bharath4793/Sensebox/Trash/Report.docx

ΕΞΩΦΥΛΟ

Acknowledgements

## Abstract

Nomenclature

- MC / MCU Microcontroller
- RH Relative Humidity
- °C Degrees Celsius
- EMC Electromagnetic Compatibility

# 1. Introduction

The purpose of this project is to measure the weather and virtualize the data. The data gathering process is implemented upon Arduino, an open source hardware prototyping platform, which allows an easy implementation of sensors and interactive elements. Data gathered by Arduino are stored on a database and on the next level these data are used to make graphs on different platforms. Also the project included a live weather camera that rotates to spot almost everywhere the user wants.

## 1.1. Motivation

Building my own weather station was an idea that came into my mind about two years ago. I first thought of building it for educational purposes and as a hobby. Later on I realized that the project could also serve as my final year’s project so I declared it.

My interested on weather data has been inherited from my favorite sport – Sailing. For sailors observing the weather is a major part of their daily routine so this was the icing on the cake to begin!

## 1.2. Purposes and targets

Sdasdasd

## 1.3. Project Structure

The project is split in four parts.

a) The Arduino part in which data are gathered.
b) The server part that hosts the server-side PHP code that is used to store and retrieve data from the database.
c) The Android Application part that visualizes the data.
d) The Web Site part that also visualizes the data.

# 2. Implementation Methodology

Cvsdfsdf

# 3. Project Plan

The project has been implemented using the latest technologies available for its needs. The next chapter state of the art provides a more in depth analysis about the background of the project.

## 3.1. State Of The Art

- Open – Source Hardware

Open - Source has become a popular expression, but mostly with regard to software. The principles and definitions of Open-Source Hardware (OSHW) are closely related to those of Open-Source Software (OSS) from the Open Source Initiative [1, 2]. Interested people can study, modify, distribute, make and sell designs based on those of OSHW products [3]. Through open development, people get the possibility to learn and understand how OSHW works, so that they are able to control and modify their technology. Machines, devices, or other physical things produced under the OSHW license must comply with the definitions of the Open Source Hardware Association [1].

- Arduino Platform

Arduino is a prototyping platform containing a microcontroller board (MC) as core element, a programming language and an integrated development environment (IDE) [4]. OSHW MCs from Arduino are based on ATmega8, ATmega168, ATmega2560 and latest boards on ATmega32u4 (http://arduino.cc/en/Main/ArduinoBoardYun), Sitara AM335x (http://arduino.cc/en/Main/ArduinoBoardTre). They can be used to develop interactive prototypes, which are using input from sensors to control output devices connected to the same board. The capabilities of the MCs allow several methods for in- and outputs of signals.

The simplified IDE with a wire-based programming language also allows beginners to realize complex projects in short time. Documentation of the IDE and the language reference can be found on the Arduino homepage [5]. All code samples are released into the public domain. Additionally, the language can be extended with C++ libraries to enable more functionality. All official software tools from Arduino are published under the OSS license and are platform-independent.

The well documented Arduino hard- and software makes it even possible to rebuild MCs by oneself. However, pre-assembled Arduino boards are relatively inexpensive compared to other commercial MC platforms available on the market

- Raspberry PI

The Raspberry PI is a credit – card – sized single board computer developed mainly for educational purposes. As core element it has a Broadcom BCM2835 system on a chip (SoC) [9] which includes an ARM11 family 700MHz processor, a VideoCore IV GPU and 512MB RAM.

The Raspberry PI foundation provides a lightweight version of Debian (Raspbian) and Arch Linux ARM distribution as official operating systems.

Tools are available for Python as the main programming language, C, Java and Perl.

For the needs of the project, the RPI is used as server, hosting the script files that are used to store and retrieve weather data in the database as well as hosting the web page. Later it is explained why the RPI is the perfect small server.

- Automated Weather Stations

Automated weather stations (AWSs) are meteorological stations, which perform climatic observations and data transmission automatically [6]. Main advantages compared to human weather observations are, that measurements, read out by a central data-acquisition unit, are more reliable and can be performed much more frequently. Sensors of an AWS are operated by a microprocessor. It allows exact sampling of sensor data and processing for averaging or filtering of the samples. The result will be a series of observations which are representative over a limited area.

- Android Platform

Android is a mobile operating system based on the Linux Kernel that is currently developed by Google. It powers hundreds of millions of mobile devices around the world. It is the largest installed base of any mobile operating system platform.

Android’s source code is released by Google under open source licenses (Apache License 2.0 and GNU General Public License 2.0 [7, 8]).

Its open nature has encouraged a large community of developers and enthusiasts to use the open – source code as a foundation for community-driven projects, which adds new features for advanced users.

- Google Chart API

The Google Chart API [10] is a tool that lets people easily create a chart from some data and embed it in a web page. Google creates a PNG (http://en.wikipedia.org/wiki/Portable_Network_Graphics) image of a chart from data and formatting parameters in an HTTP (http://en.wikipedia.org/wiki/HTTP) request. Many types of charts are supported, and by making the request into an image tag, people can simply include the chart in a web page.

# 4. Basic Part

//TODO REQUIREMENT ANALYSIS

## 4.1. Hardware Components

The Microcontroller controls the data storage process and sampling frequency. Sampling rates of sensors are depending on the time constant value that we set. Sensors and Microcontroller functionality is explained in depth in the upcoming section.

### 4.1.1. Arduino

The Arduino and the Ethernet Shield can be imagined as the ‘brain’ of the weather station. It provides all the core functionality from sensor manipulation up to data logging. The Arduino Mega and the Arduino Ethernet Shield are introduced below.

#### 4.1.1.1. Arduino Mega 2560 R3

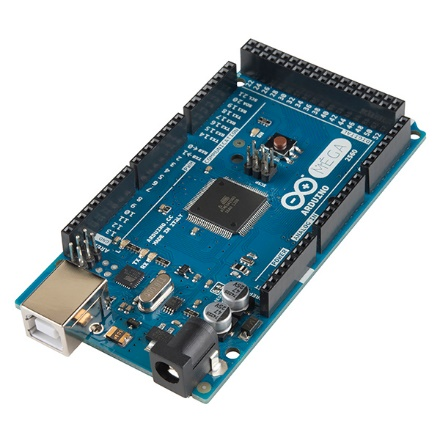
[picture p3: figure]

Figure 1 - The Arduino Mega 2560 R3 Microcontroller Board

Arduino Mega 2560 [11] is the board that is powered by ATmega2560. Its main advantages compared to other Arduino boards are the clock speed of 16MHz, the flash memory of 256Kbytes of the ATmega2560 chip and the 8Kbytes SRAM. The large flash and SRAM memories offer the Arduino vast of space for more interactive components to be added in future improvements.

The Arduino Mega provides 54 digital pins. They can be used as input or output and are operating at 5V. Each pin can provide or receive a maximum of 40mA and has an internal pull-up resistor of 20 – 50 kΩ. The pull-up resistor is disconnected by default but they can be accessed from software by setting the pinMode() as INPUT_PULLUP. This effectively inverts the behavior of the INPUT mode, where HIGH means the sensor is off, and LOW means the sensor is on. In addition, some pins have specialized functions:

- Serial: 0 (RX) and 1 (TX); Serial 1: 19 (RX) and 18 (TX); Serial 2: 17 (RX) and 16 (TX); Serial 3: 15 (RX) and 14 (TX).

Used to receive (RX) and transmit (TX) TTL serial data. Pins 0 and 1 are also connected to the corresponding pins of the ATmega16U2 USB-to-TTL Serial chip.

- External Interrupts: 2 (interrupt 0), 3 (interrupt 1), 18 (interrupt 5), 19 (interrupt 4), 20 (interrupt 3), and 21 (interrupt 2).

These pins can be configured to trigger an interrupt on a low value, a rising or falling edge, or a change in value. See the attachInterrupt() function for details.

- PWM: 2 to 13 and 44 to 46.

Provide 8-bit PWM output with the analogWrite() (http://arduino.cc/en/Reference/AnalogWrite) function.

- SPI: 50 (MISO), 51 (MOSI), 52 (SCK), 53 (SS).

These pins support SPI communication using the SPI library.

- LED: 13.

There is a built-in LED connected to digital pin 13. When the pin is HIGH value, the LED is on, when the pin is LOW, it's off.

- TWI: 20 (SDA) and 21 (SCL).

Support TWI communication using the Wire library (http://arduino.cc/en/Reference/Wire).

(BMP085 sensor uses the Wire protocol to communicate with Arduino)

The Mega2560 has 16 analog inputs, each of which provide 10 bits of resolution (i.e. 2¹⁰ different values). By default they measure from ground to 5 volts, though is it possible to change the upper end of their range using the AREF pin and analogReference() function.

#### 4.1.1.2. Arduino Ethernet Shield

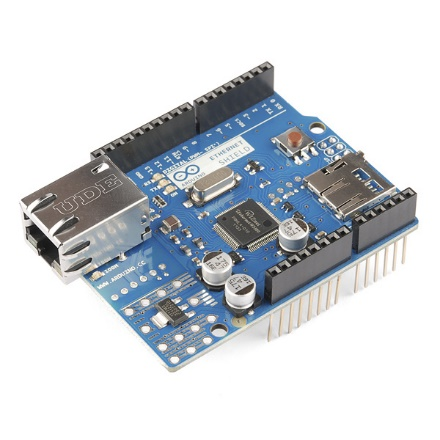
[picture p4: figure]

Figure 2 - The Arduino Ethernet Shield

The Ethernet shield [12] is powered by a Wiznet W5100 ethernet controller and also includes a micro SD card slot for storage purposes. It is made exclusively for Arduino boards and connects over the SPI port.

The Wiznet W5100 provides a network (IP) stack capable of both TCP and UDP. It supports up to four simultaneous socket connections. The ethernet shield connects to an Arduino board using long wire-wrap headers which extend through the shield. This keeps the pin layout intact and allows another shield to be stacked on top.

The Ethernet Shield has a standard RJ-45 connection, with an integrated line transformer and Power over Ethernet enabled.

It worth mentioning that pins SPI pins cannot be used as digital in or output any more when using the Ethernet Shield as they are being used by the SPI bus. Pins 4, 10 are used for the SD card and cannot be used as well. All the other pins are free to be used.

The Ethernet Shield is used in the project for data logging and as server for controlling the pan-tilt camera mount.

To integrate functionalities of the Ethernet Shield into the whole system, Ethernet [13] and SD [14] libraries are used.

### 4.1.2. Sensors

In this section the functionality and the characteristics of each sensors used by the prototype will be analyzed. In addition, connection and communication examples are given in this section.

#### 4.1.2.1. Relative Humidity and Air Temperature (DHT22 or RHT03)

The RHT03 sensor from is made of two parts, a capacitive humidity sensor and a thermistor. There is also a basic chip inside that does some analog to digital conversion and offers a digital signal with the temperature and humidity.

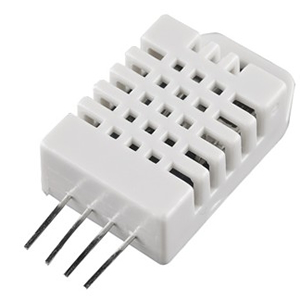
[picture p5: figure]

Figure 3 - RHT03

The RHT03 was chosen because of its high Resolution and Accuracy. Technical Specifications are shown in the table below [15].

Model | DHT 22 also known as RHT03
Power Supply | 3.3 – 6V DC
Output Signal | Digital Signal via MaxDetect 1-wire bus
Sensing Element | Polymer Humidity Capacitor
Operating Range | Humidity: 0 – 100% RH Temperature: - 40 ~ 80 °C
Accuracy | Humidity: +- 2% RH (Max +-5% RH) Temperature: +- 0.5 °C
Resolution or Sensitivity | Humidity: 0.1% RH Temperature: 0.1 °C
Repeatability | Humidity: +- 1% RH Temperature: +- 0.2 °C

Table 1 - RHT03 Technical Specifications

Pin | Function
1 | Power Supply
2 | Data – Signal
3 | NULL
4 | Ground

Table 2 - RHT03 Pin Sequence Number (1, 2, 3, 4 from left to right)

##### Communication and signal

Wire Bus is used for communication between the MCU and RHTY03.

Illustration of MaxDetect’s wire bus:

Data is comprised of integral and decimal part, the following is the formula for data.

- 8bit integral Relative Humidity data
- 8bit decimal Relative Humidity data
- 8bit integral Temperature data
- 8bit decimal Temperature data
- 8but checksum

When MCU send start signal, RHT03 change from standby-status to running-status. When MCU finishs sending the start signal, RHT03 will send response signal of 40-bit data that reflect the relative humidity and temperature to MCU. Without start signal from MCU, RHT03 will not give response signal to MCU. One start signal for one response data from RHT03 that reflect the relative humidity and temperature. RHT03 will change to standby status when data collecting finished if it don't receive start signal from MCU again.

Below one can find the overall communication process. The interval of whole process must beyond two seconds.

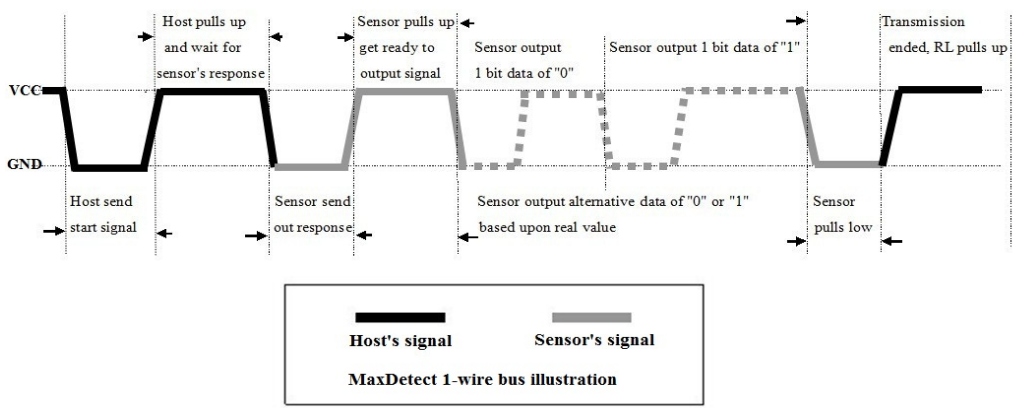
[picture p6: figure]

Figure 4 - RHT03 Communication Process

#### 4.1.2.2. Air Pressure and Temperature (BMP085)

For air pressure readings and temperature the digital sensor BMP085 from Bosch Sensortec is used [16]. It was chosen for the prototype because of its good accuracy through individual precise calibration and its long term stability feature. The main characteristics are summarized in the table below.

Parameter | Condition | Min | Typical | Max | Unit
Resolution | Typical | 0.04 | 0.01 | 0.01 | hPA
Accuracy | Typical | | +- 1.0 | | hPA
Response Time | Mode | 4.5 | | 25.5 | Ms
Operation Range | | 700 | | 1100 | hPA
Supply Voltage | | 1.8 | 2.5 | 3.6 | Volts

Table 3 - Main Properties of the BMP085

It is based on piezo - resistive technology for EMC robustness, high accuracy and linearity as well as long term stability. It is designed to be connected directly to a MCU via the I²C bus. The pressure and temperature data has to be compensated by the calibration data of the E²PROM of the BMP085.

The sensor consists of a piezo – resistive sensor, an analog to digital converter and a control unit with E²PROM and a serial I²C interface. It delivers the uncompensated value of pressure and temperature. The E²PROM has stored 176 bit of individual calibration data. This is used to compensate offset, temperature dependence and other parameters of the sensor.

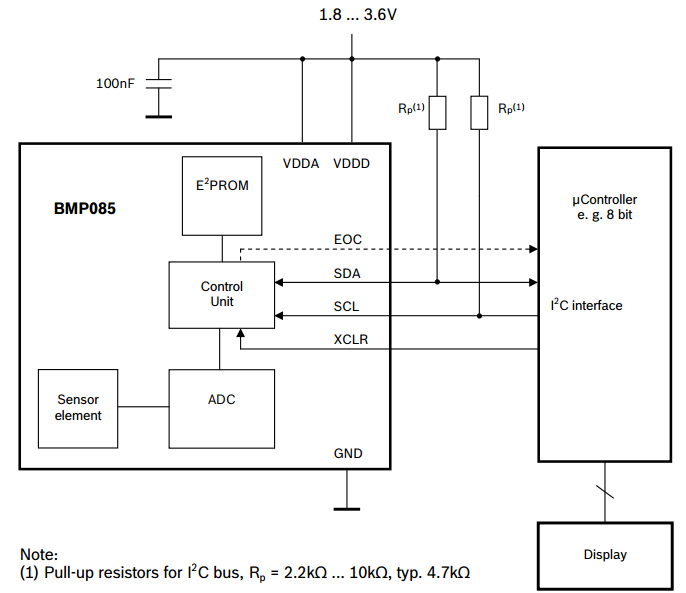
[picture p7: figure]

Figure 5 - BMP085 Application Circuit

The I²C interface and a read-only-memory register (E²PROM) are part of the control unit of the BMP085. In the E²PROM eleven 16bit calibration coefficients are stored and used to compensate offset of temperature and pressure readings. As temperature is a factor for air pressure calculation, it has to be known to calculate the true pressure. Reading of the temperature can be done with the piezo-resistive sensor as well.

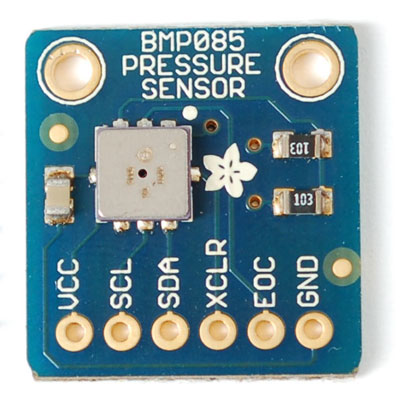
[picture p8: figure]

Figure 6 - BMP085

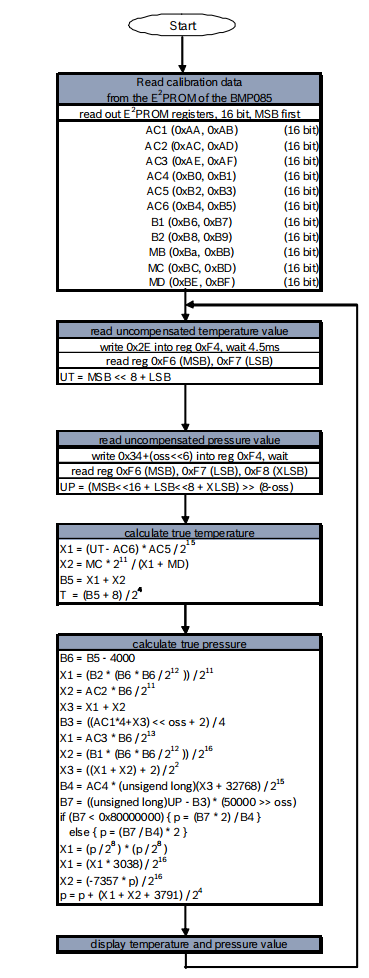
[picture p9: figure]

Figure 7 - Calculation Process of Pressure and Temperature for BMP085

A measurement sequence with the complete algorithm is shown in Figure 6. It has to be implemented to the MCU according to this order.

After the MC has sent a start sequence, the calibration data is requested from the E²PROM registers. The 16 constants need to be read out only once and are stored on the MCU. Then the MCU has to wait for uncompensated temperature (UT) and pressure (UP) readings from the sensors. The stored calibration data is now used to calculate temperature in °C and pressure in Pa. After applying the algorithms, the sensor waits for the next measurement command.

As additional factor for true pressure calculation, an oversampling mode can be chosen to set the internal sampling of the sensor for one measurement. Changing the mode to a higher resolution will increase the accuracy of a measurement but also has an impact on energy consumption, reaction time and the long term stability [17].

Table 4 gives an overview about the four oversampling setting modes. As the weather station is designed for long and continuous measurements, standard mode will be sufficient.

Figure 8 - BMP085 Temperature and Pressure Reading Process

Mode | Oversamping Setting | Internal Samples | Conversion Time (ms) | Noise (hPA)
Ultra Low Power | 0 | 1 | 4.5 | 0.0.6
Standard | 1 | 2 | 7.5 | 0.05
High Resolution | 2 | 4 | 13.5 | 0.0.4
Ultra High Resolution | 3 | 8 | 25.5 | 0.03

Table 4 - Measurement modes of the BMP085 and resolution effects

BMP085 | Arduino Mega Pin
SDA | 20
SCL | 21
XCLR | Not Connected
EOC | Not Connected
GND | GND
VCC | 3.3V

As mentioned before, the BMP085 sensor is using the I²C protocol to communicate with the MCU and has to be connected to SDA and SCL pins of the Arduino Mega as shown below.

Table 5 - BMP085 Pin Connections to Arduino Mega

The altitude of the instrument has to be taken into account as well, because air pressure decreases with increasing height. For getting comparable values it has to be calculated to sea level pressure [6].

Working with the BMP085 should be done carefully, because it could be damaged by shocks or when getting in contact with water. It should be handled as Electrostatic Sensitive Device (ESD) [18] too. Therefore, it should be installed in a dry environment with constant temperature.

#### 4.1.2.3. Precipitation

Rainfall is measured by a Tipping Bucket Rain Gauge included in the Weather Meters Kit [19] available from Sparkfun. Each time the self – emptying tipping bucket is emptied, a reed switch closes once. This corresponds to 0.2794 mm of rain fall [20]. The state change is caught by the MCU using Arduino’s Interrupt input.

A problem that frequently appears at trying to capture the state change of a switch is called bouncing problem. State change means that the input at a digital pin on the Arduino changes from high to low (equals from 5V to 0V) or vice versa. The problem is that each switching contains interferences in the signal before it reaches the level of 5V or 0V. This can lead to multiple counts from only one state switch. A visualization of the problem is shown in Figure 5.

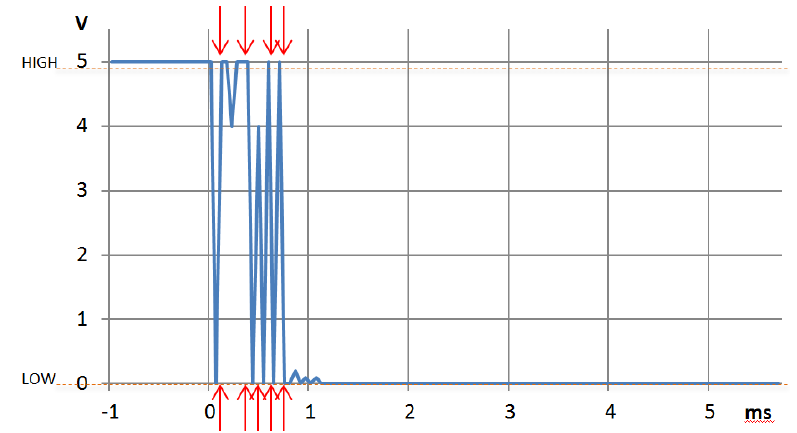
[picture p10: figure]

Figure 9 - Bouncing problem at a digital input. MCU will read nine state changes instead of one

To overcome this problem there are two solutions. The first is to integrate a capacitor to the circuit and the second is to define a software method with a debounce interval of some microseconds (μs), which is called very time a state change is recognized.

For the project the second method is used. The implementation is show below.

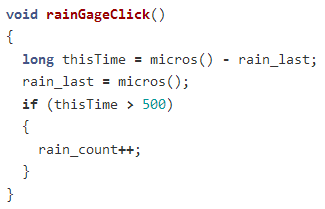
[picture p11: figure]

Figure 10 - Switch Debouncing Implementation

The code above will ignore any interrupt that occurs within 500μs (0.0005s) of the previous one. This technique will limit the max rain this configuration can measure to a very high value that do not corresponds to an earthly value.

##### Wiring the Rain Gauge

The two wires coming from the rain gauge, through the RJ11 cable, have to be connected to the Arduino Mega as shown in the figure below.

Figure 11 - Connection of the Rain Gauge to the Arduino Mega

The red line must be connected to Ground while the green line is pulled up with a 10kΩ resistor to 5V. The output of the sensor has to be connected to digital pin 19 on the Arduino Mega.

A disadvantage of this method is that only rain fall can be measured. To include snow fall in the precipitation measurement a self heated device would be needed. Temperatures below 0° Celsius could also lock up the anemometer. This should be taken into account when analyzing the data of the rain gauge.

# References

[1] Open Source Initiative: The Open Source Definition.

http://opensource.org/docs/osd

[2] Open Source Hardware Association: OSHW Definition.

http://www.oshwa.org/definition/

[3] Definition of Free Cultural Works: Open Source Hardware. http://freedomdefined.org/OSHW (http://freedomdefined.org/OSHW%20)
[4] Arduino: Homepage

http://arduino.cc/en

[5] Arduino: Reference.

http://arduino.cc/en/Reference/HomePage

[6] World Meteorological Organization, 1992: International Meteorological Vocabulary. Second edition, WMO-No. 182,Geneva.
[7] Apache License, Version 2.0

http://www.apache.org/licenses/LICENSE-2.0.html

[8] GNU General Public License, Version 2.0

http://www.gnu.org/licenses/gpl-2.0.html

[9] System on a chip

http://en.wikipedia.org/wiki/System_on_a_chip

[10] Google Charts API

https://developers.google.com/chart/

[11] Arduino Mega 2560 R3 Web page.

http://arduino.cc/en/Main/ArduinoBoardMega2560

[12] Arduino Ethernet Shield Web page.

http://arduino.cc/en/Main/ArduinoEthernetShield

[13] Arduino Ethernet Library Web page.

http://arduino.cc/en/reference/ethernet

[14] Arduino SD Library Web page.

http://arduino.cc/en/Reference/SD

[15] RHT03 Official Datasheet.

http://dlnmh9ip6v2uc.cloudfront.net/datasheets/Sensors/Weather/RHT03.pdf

[16] Bosch Sensortec: Pressure Sensors.

http://goo.gl/SEpmgY

[17] BMP085 Datasheet.

http://dlnmh9ip6v2uc.cloudfront.net/datasheets/Sensors/Pressure/BST-BMP085-DS000-06.pdf

[18] Electrostatic Sensitive Device

http://en.wikipedia.org/wiki/Electrostatic-sensitive_device

[19] Sparkfun Electronics: Weather Meters Kit

https://www.sparkfun.com/products/8942

[20] Sparkfun Electronics: Weahter Meters Datasheet

https://www.sparkfun.com/datasheets/Sensors/Weather/Weather%20Sensor%20Assembly..pdf
