bharath4793/Sensebox/Raw Data/Pics/20141013_182844.jpg

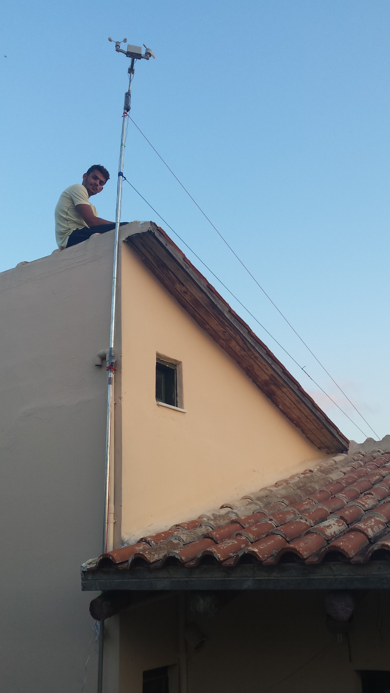
Raw Data/Pics/20141013_182844.jpg
