bharath4793/Sensebox/Raw Data/Pics/android_app/2014-10-21 00.14.27.png

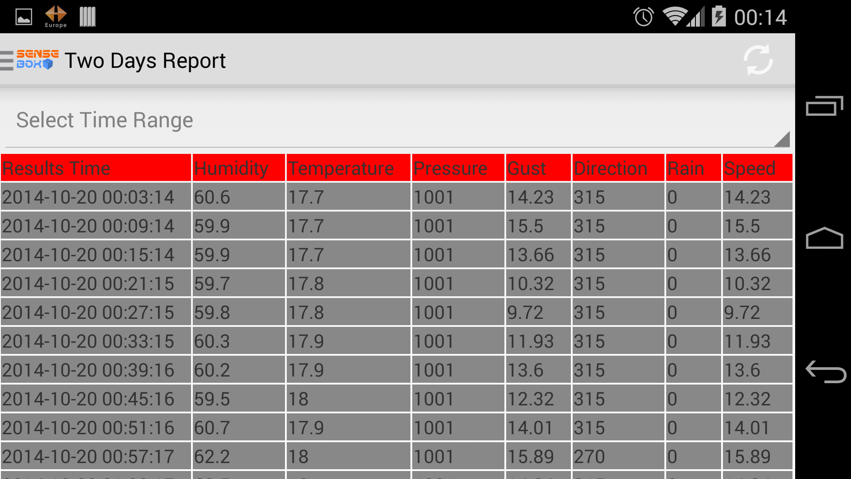
Raw Data/Pics/android_app/2014-10-21 00.14.27.png
