bharath4793/Sensebox/Raw Data/Pics/android_app/2014-10-21 00.14.45.png

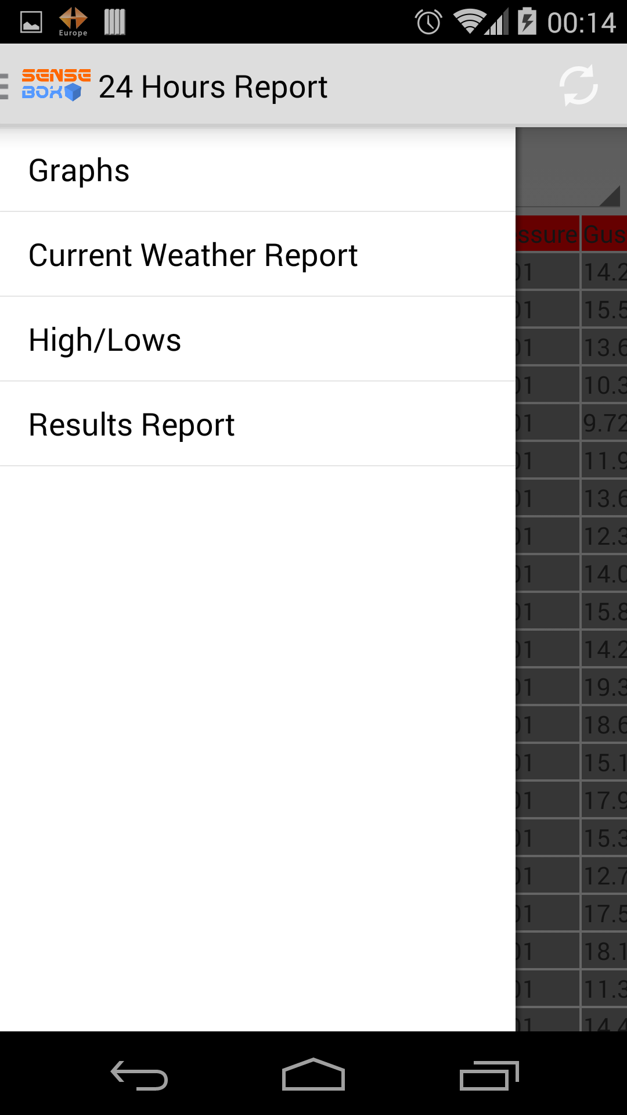
Raw Data/Pics/android_app/2014-10-21 00.14.45.png
