bharath4793/Sensebox/Raw Data/Pics/Arduino-Mega-2560-with-ethernet-shield-1024.JPG

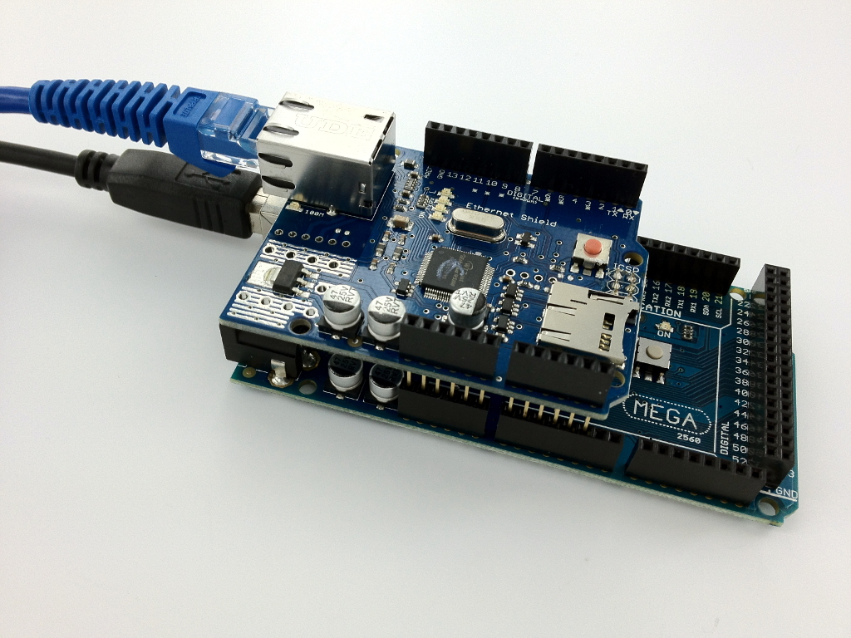
Raw Data/Pics/Arduino-Mega-2560-with-ethernet-shield-1024.JPG
