bharath4793/Sensebox/Raw Data/Pics/BMP085/bmp085_circuit.png

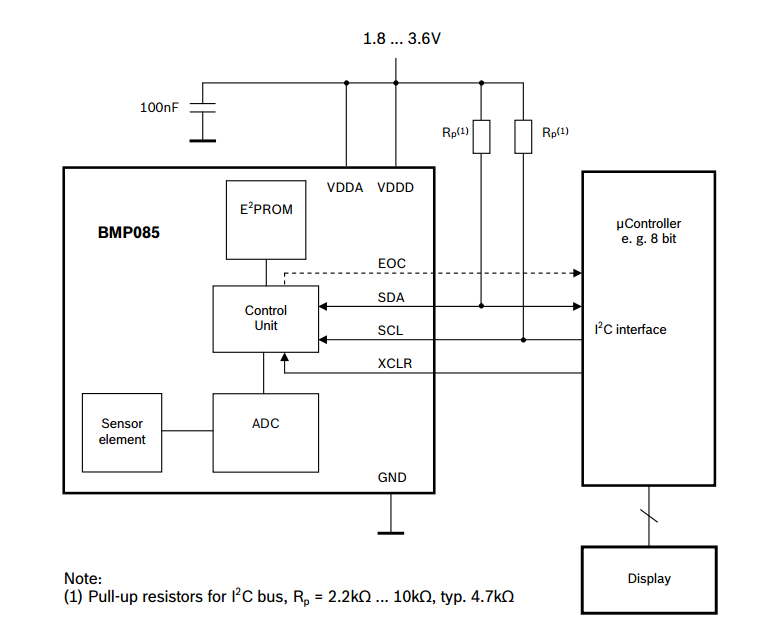
Raw Data/Pics/BMP085/bmp085_circuit.png
