bharath4793/Sensebox/Raw Data/Pics/crontab.png

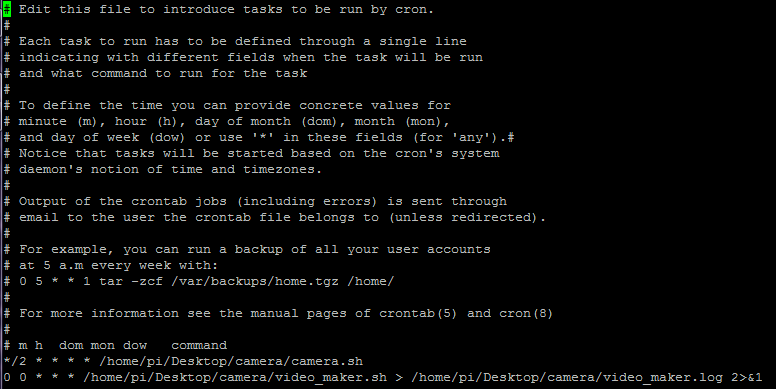
Raw Data/Pics/crontab.png
