bharath4793/Sensebox/Raw Data/Pics/draw_charts_code/drawGraphs.png

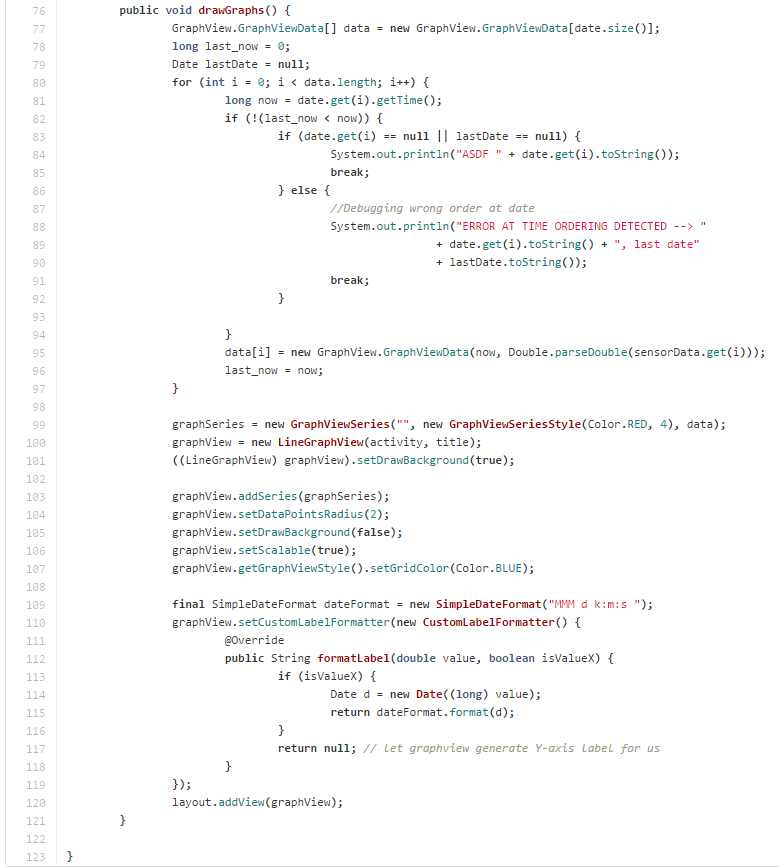
Raw Data/Pics/draw_charts_code/drawGraphs.png
