bharath4793/Sensebox/Raw Data/Pics/draw_charts_code/json_structor.png

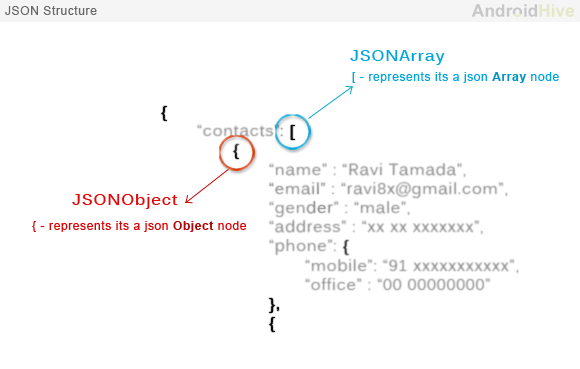
Raw Data/Pics/draw_charts_code/json_structor.png
