bharath4793/Sensebox/Raw Data/Pics/draw_charts_code/jsonArray_filling.png

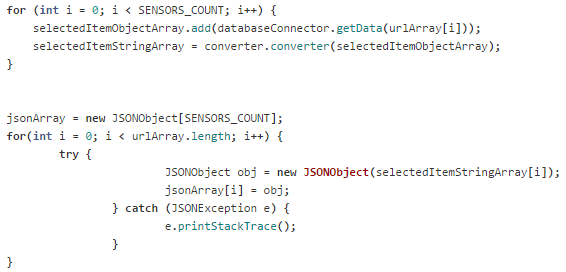
Raw Data/Pics/draw_charts_code/jsonArray_filling.png
