bharath4793/Sensebox/Raw Data/Pics/draw_charts_code/min_max.png

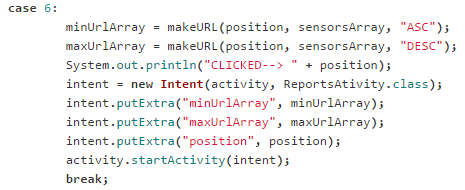
Raw Data/Pics/draw_charts_code/min_max.png
