bharath4793/Sensebox/Raw Data/Pics/draw_charts_code/resolver.png

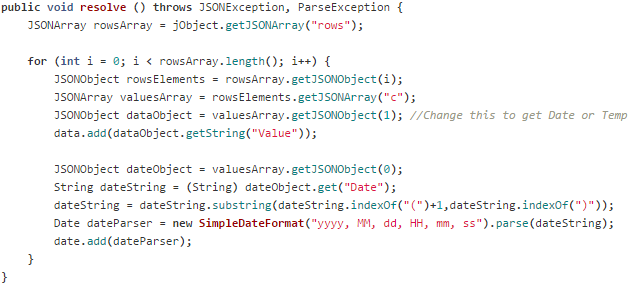
Raw Data/Pics/draw_charts_code/resolver.png
