bharath4793/Sensebox/Raw Data/Pics/generated_HTTP_request.png

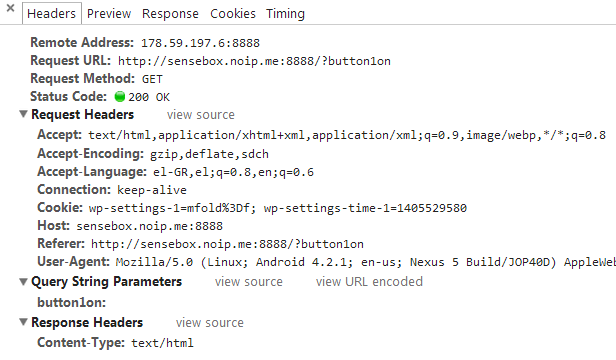
Raw Data/Pics/generated_HTTP_request.png
