bharath4793/Sensebox/Raw Data/Pics/get_gust_function.png

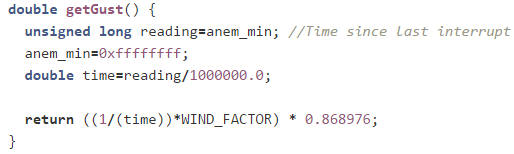
Raw Data/Pics/get_gust_function.png
