bharath4793/Sensebox/Raw Data/Pics/http_request.png

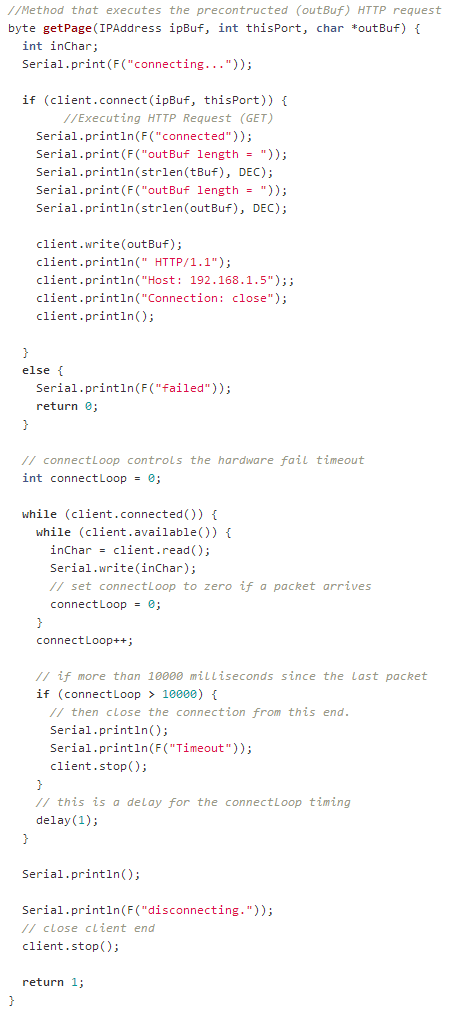
Raw Data/Pics/http_request.png
