bharath4793/Sensebox/Raw Data/Pics/http_response.png

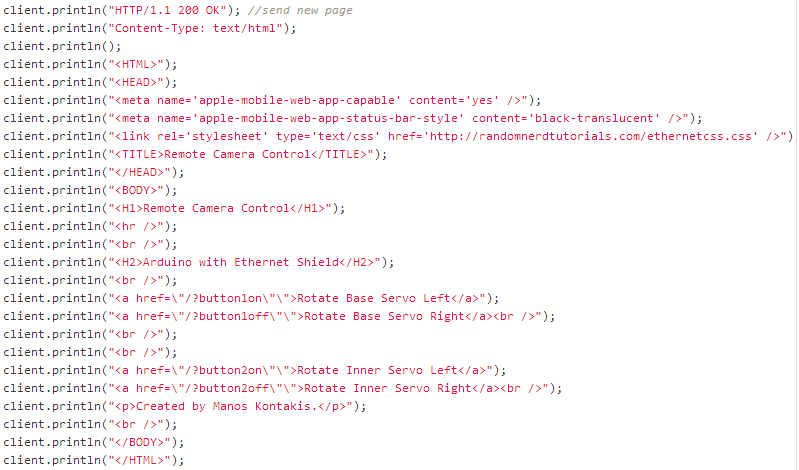
Raw Data/Pics/http_response.png
