bharath4793/Sensebox/Raw Data/Pics/http_url_precontruction.png

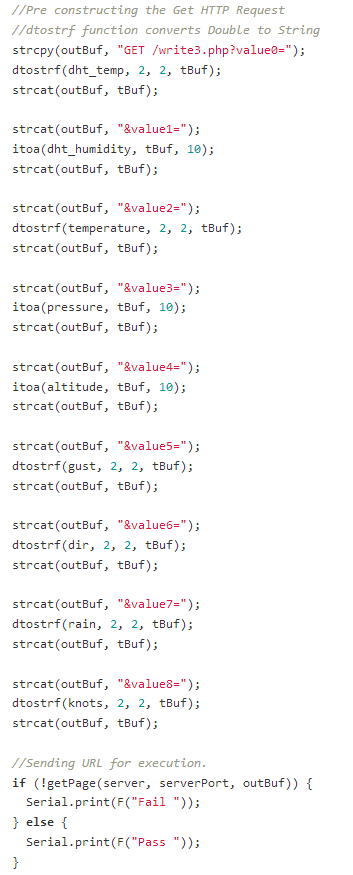
Raw Data/Pics/http_url_precontruction.png
