bharath4793/Sensebox/Raw Data/Pics/jsonization.png

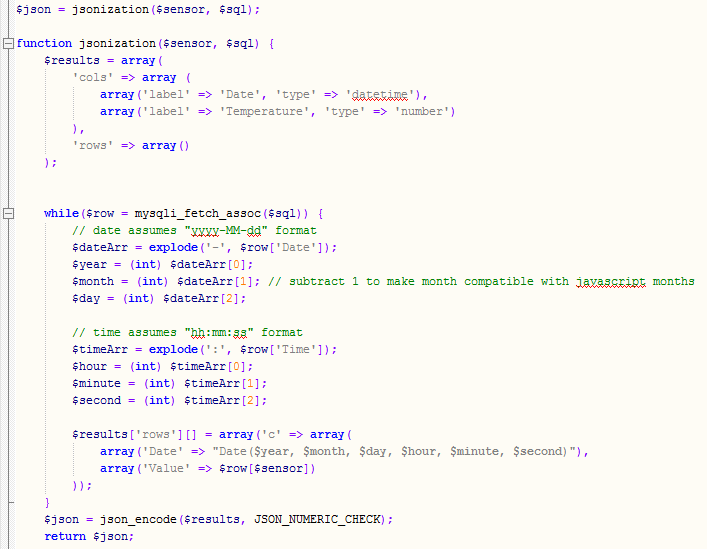
Raw Data/Pics/jsonization.png
