bharath4793/Sensebox/Raw Data/Pics/monthlySQLquery.png

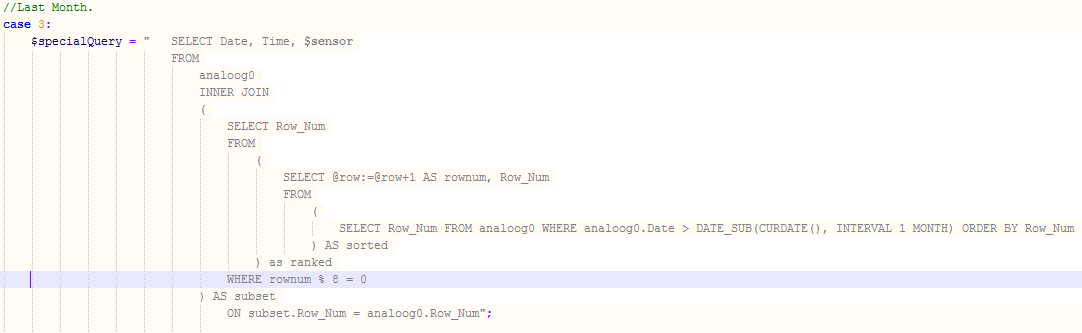
Raw Data/Pics/monthlySQLquery.png
