bharath4793/Sensebox/Raw Data/Pics/PHP_db_writer.png

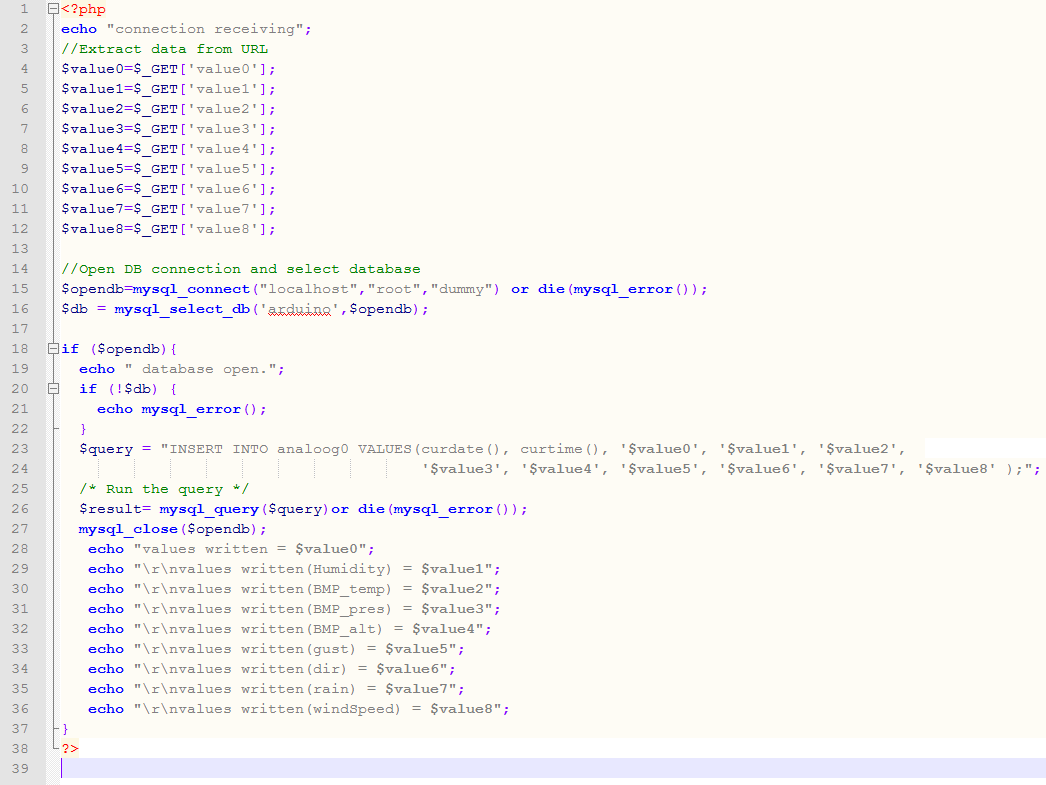
Raw Data/Pics/PHP_db_writer.png
