bharath4793/Sensebox/Raw Data/Pics/prototype/DSCN5546.JPG

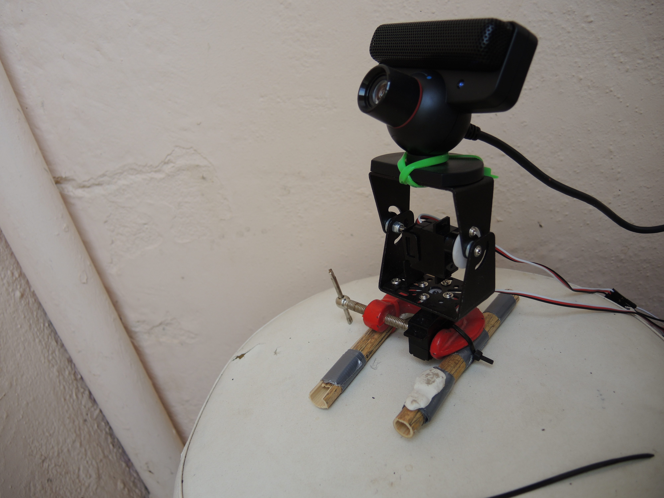
Raw Data/Pics/prototype/DSCN5546.JPG
