bharath4793/Sensebox/Raw Data/Pics/remote_camera_control.png

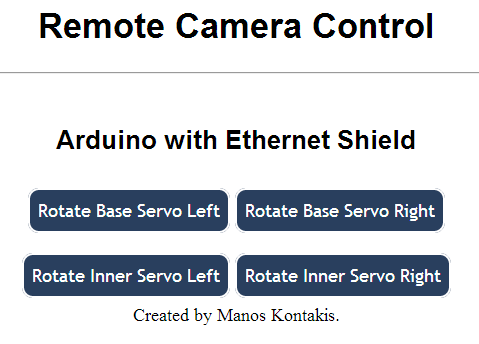
Raw Data/Pics/remote_camera_control.png
