bharath4793/Sensebox/Raw Data/Pics/servo_rotate.png

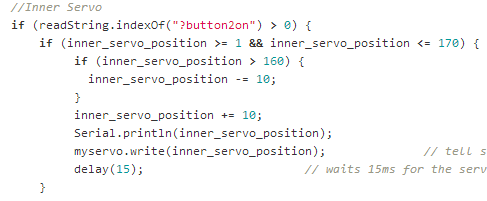
Raw Data/Pics/servo_rotate.png
