bharath4793/Sensebox/Raw Data/Pics/spinner_hack.png

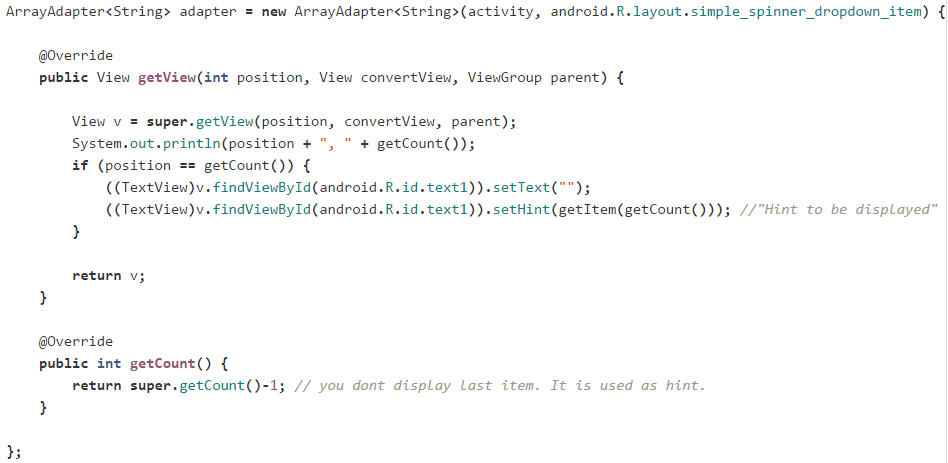
Raw Data/Pics/spinner_hack.png
