bharath4793/Sensebox/Raw Data/Pics/table_layout_code/add_data_to_table.png

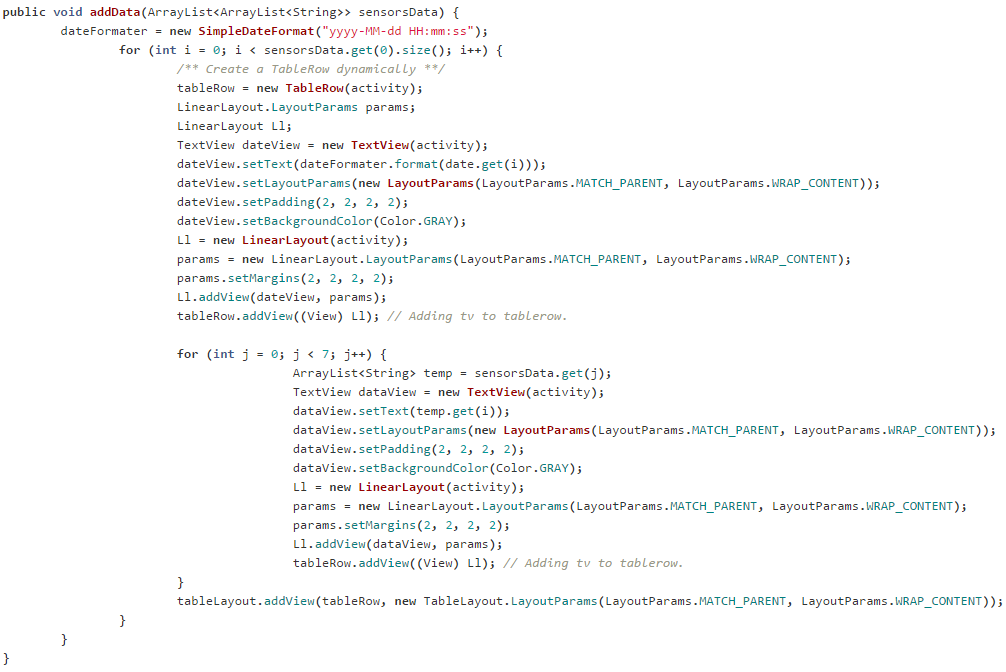
Raw Data/Pics/table_layout_code/add_data_to_table.png
