bharath4793/Sensebox/Raw Data/Pics/table_layout_code/big_array_list_for_table_layout.png

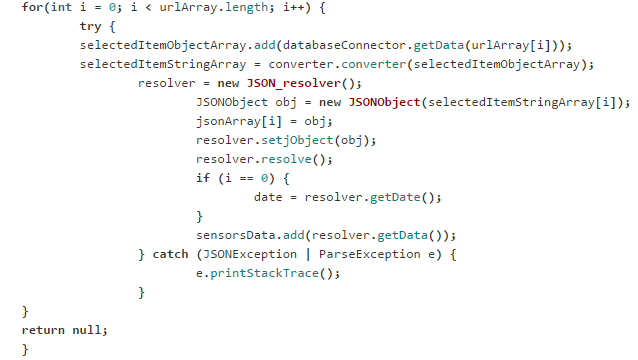
Raw Data/Pics/table_layout_code/big_array_list_for_table_layout.png
