bharath4793/Sensebox/Raw Data/Pics/time_lapse_example.gif

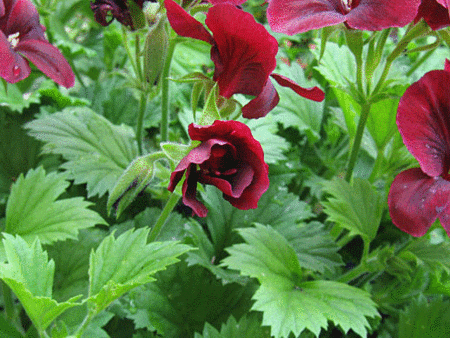
Raw Data/Pics/time_lapse_example.gif
