bharath4793/Sensebox/Raw Data/Pics/watchdog_timer_implementation.png

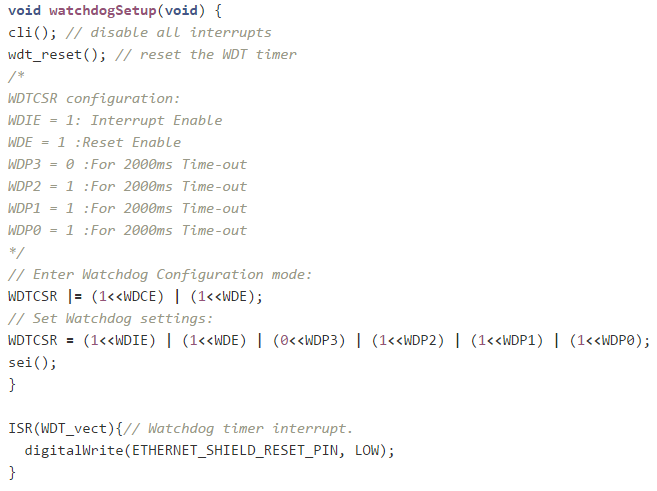
Raw Data/Pics/watchdog_timer_implementation.png
