bharath4793/Sensebox/Raw Data/Pics/watchdog_timer_schematic.png

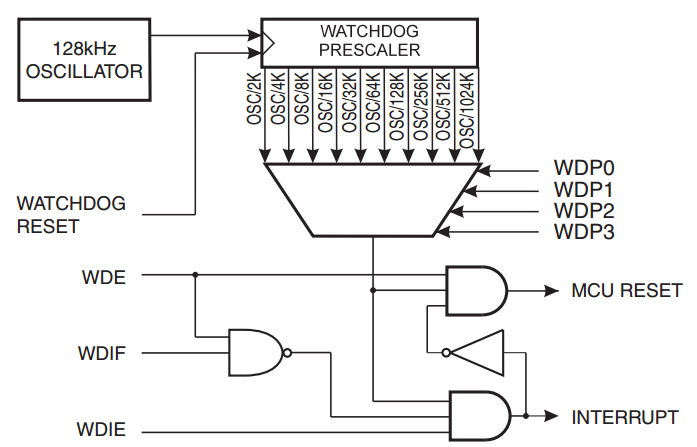
Raw Data/Pics/watchdog_timer_schematic.png
