bharath4793/Sensebox/Raw Data/Pics/web_page/draw_graph_js_script.png

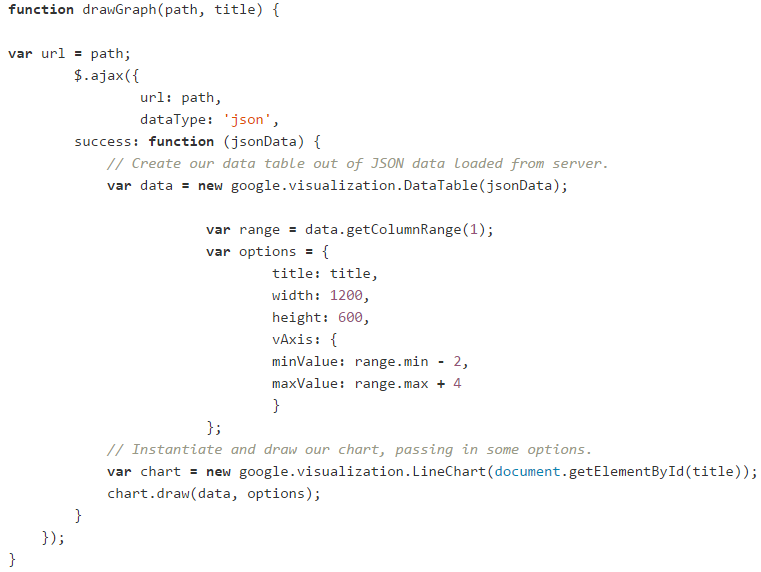
Raw Data/Pics/web_page/draw_graph_js_script.png
