bharath4793/Sensebox/Raw Data/Pics/web_page/graphs.png

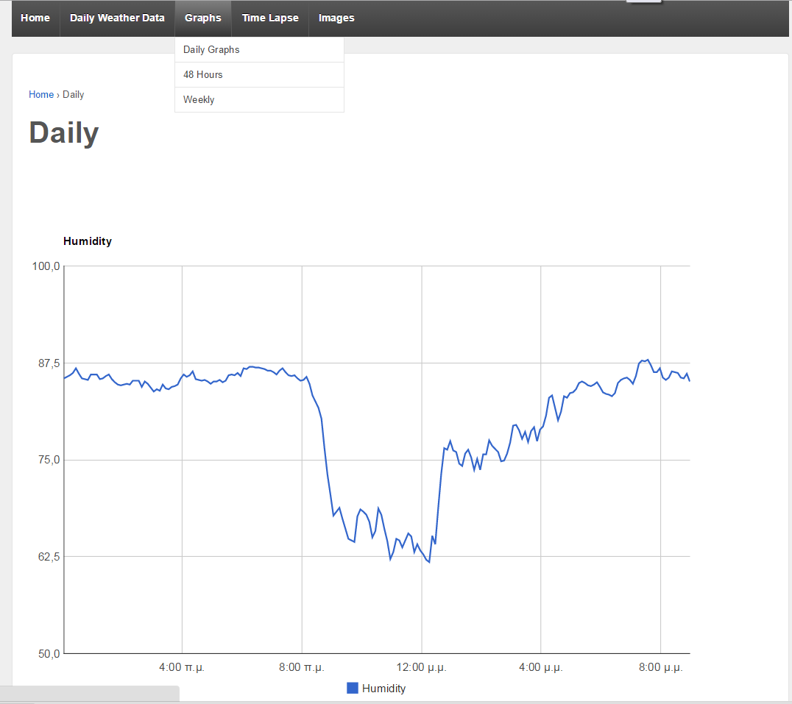
Raw Data/Pics/web_page/graphs.png
