bharath4793/Sensebox/Raw Data/Pics/web_page/table.png

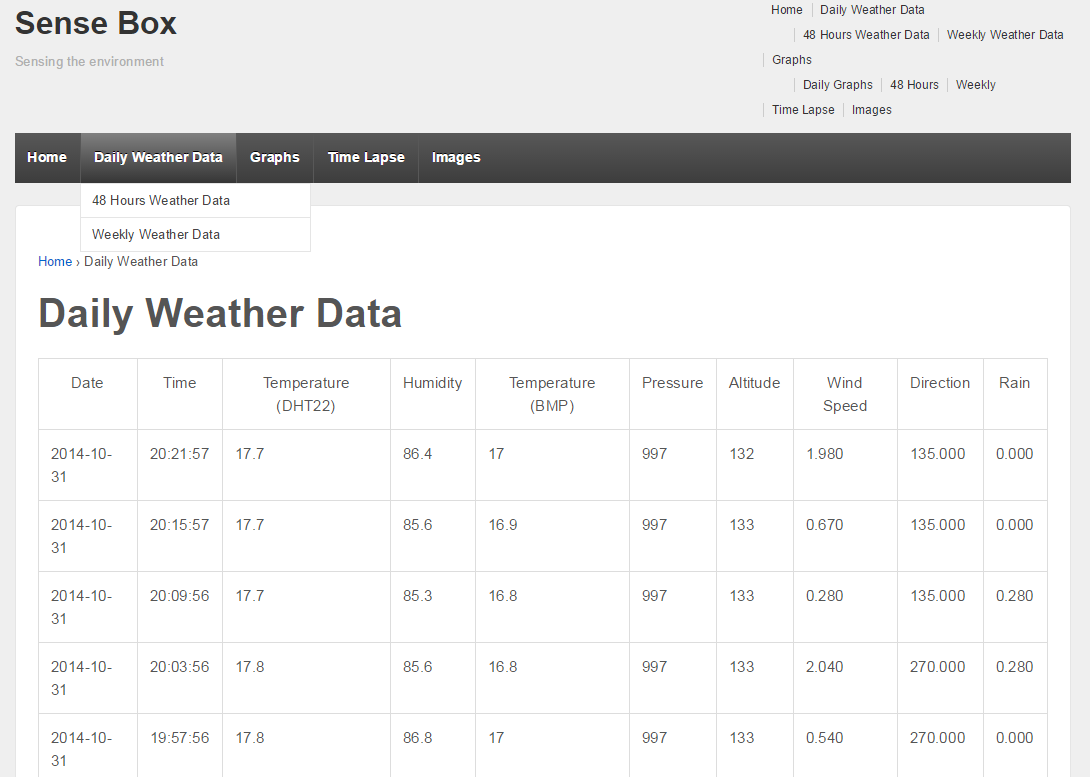
Raw Data/Pics/web_page/table.png
