bharath4793/Sensebox/Raw Data/Pics/web_page/time_lapse.png

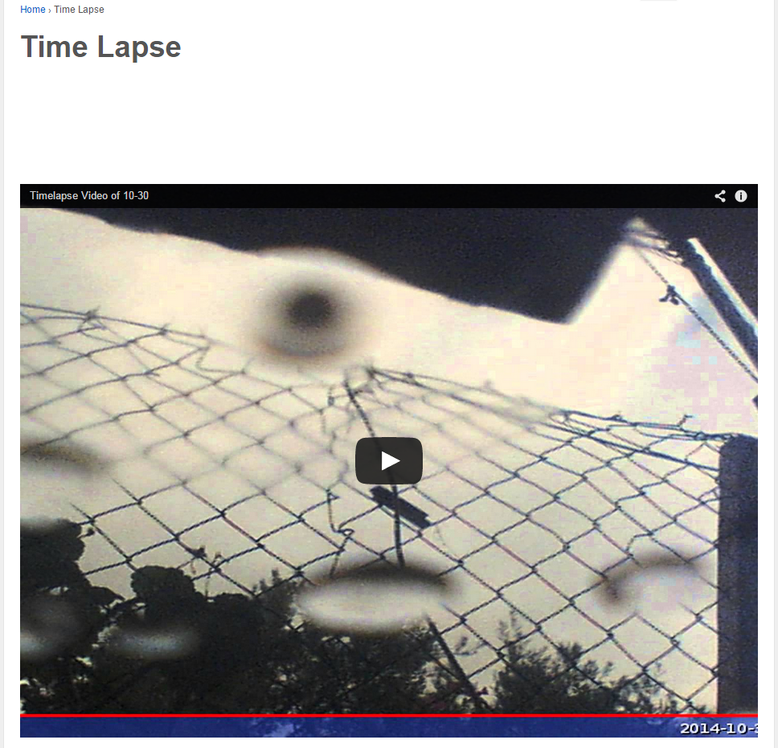
Raw Data/Pics/web_page/time_lapse.png
