bharath4793/Sensebox/Raw Data/Pics/web_page/web_home_page.png

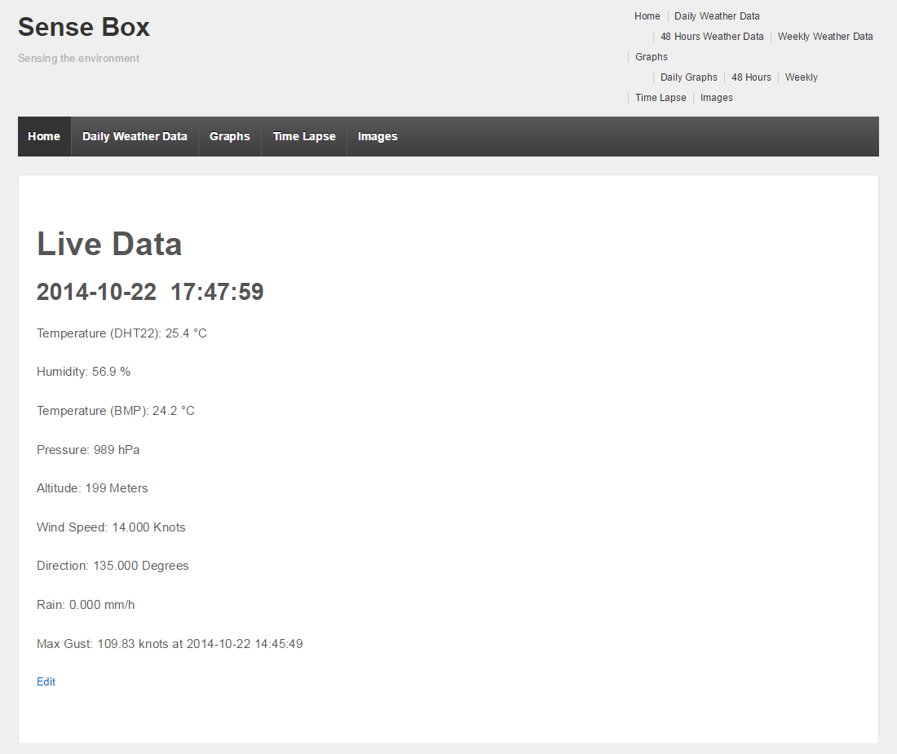
Raw Data/Pics/web_page/web_home_page.png
