bharath4793/Sensebox/Raw Data/Pics/web_page/Χωρίς τίτλο.png

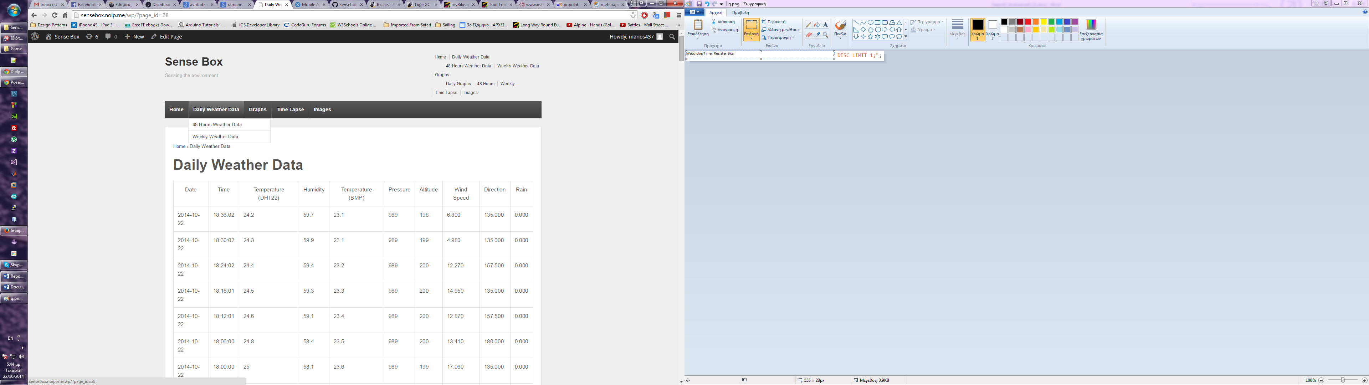
Raw Data/Pics/web_page/Χωρίς τίτλο.png
