bharath4793/Sensebox/Raw Data/Pics/web_servers_comparison/raspberry-pi-web-server-05.png

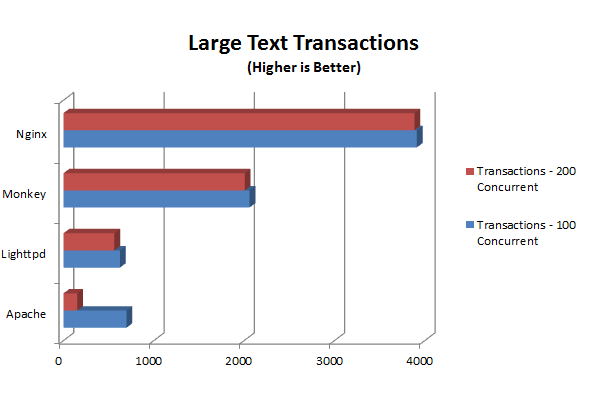
Raw Data/Pics/web_servers_comparison/raspberry-pi-web-server-05.png
