bharath4793/Sensebox/Raw Data/Pics/youtube.png

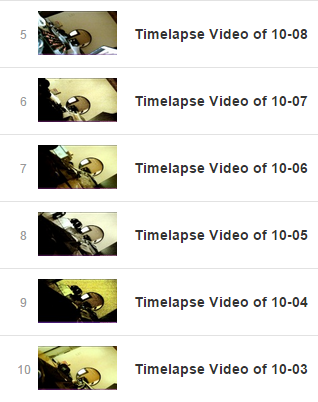
Raw Data/Pics/youtube.png
