bharath4793/Sensebox/Raw Data/Schematic/schematic_v2_bb.png

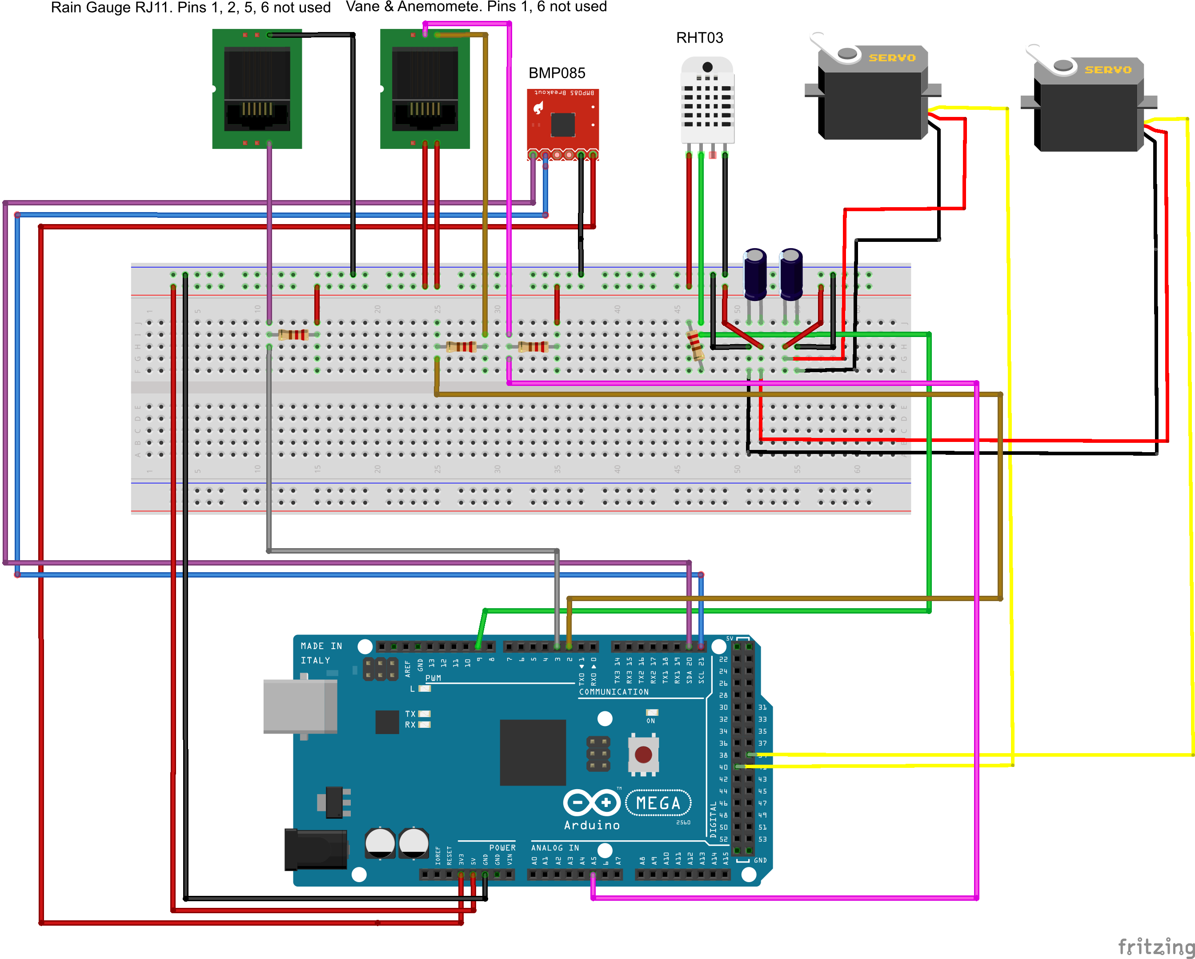
Raw Data/Schematic/schematic_v2_bb.png
