bharath4793/Sensebox/Trash/asdf.png

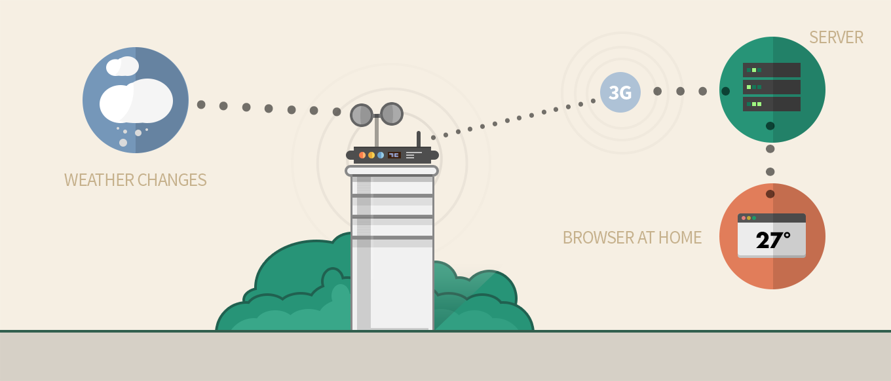
Trash/asdf.png
