bharath4793/Sensebox/Trash/SO.png

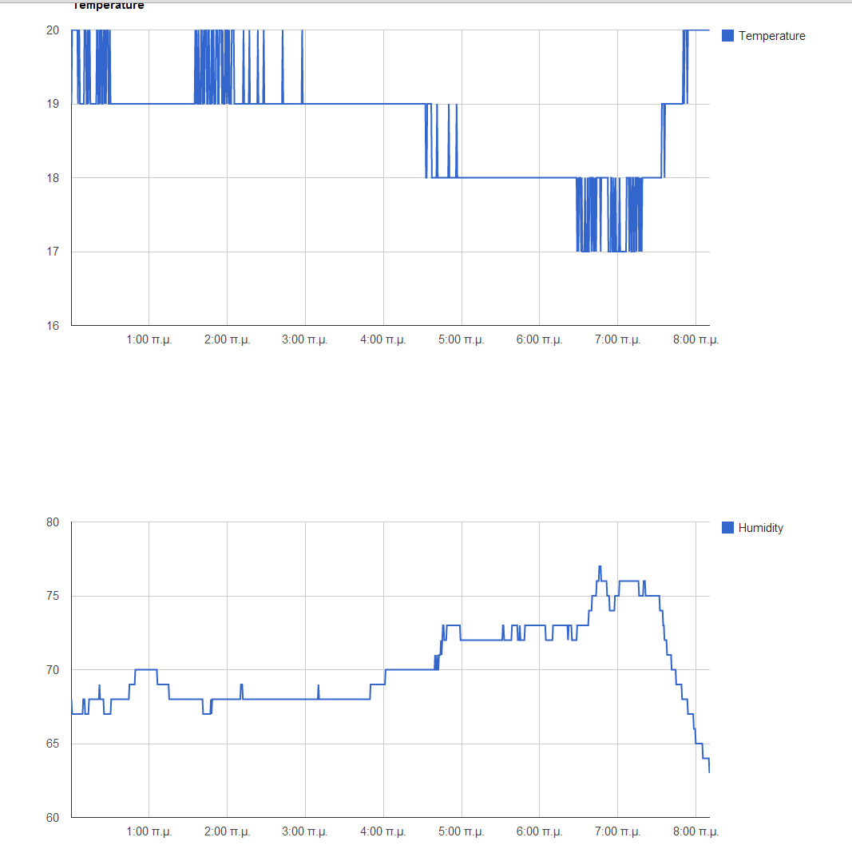
Trash/SO.png
