bharath4793/Sensebox/Trash/WS_1.jpg

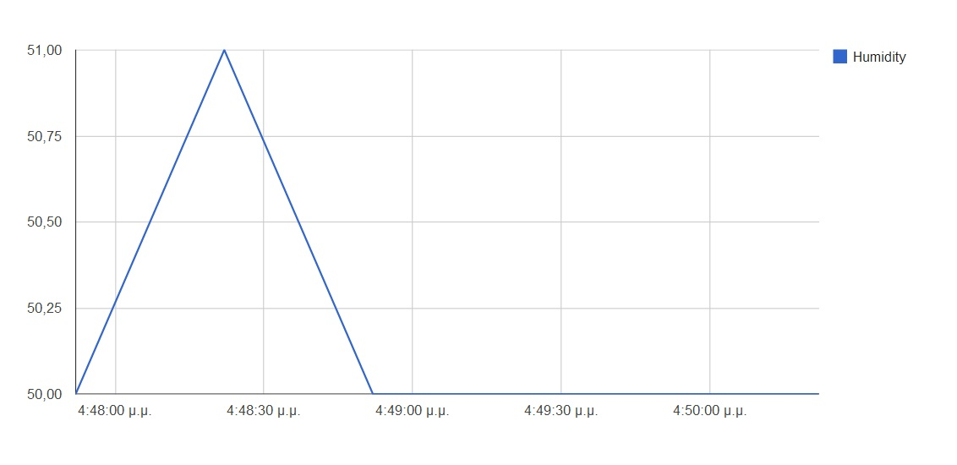
Trash/WS_1.jpg
