bharath4793/Sensebox/Trash/WS_2.jpg

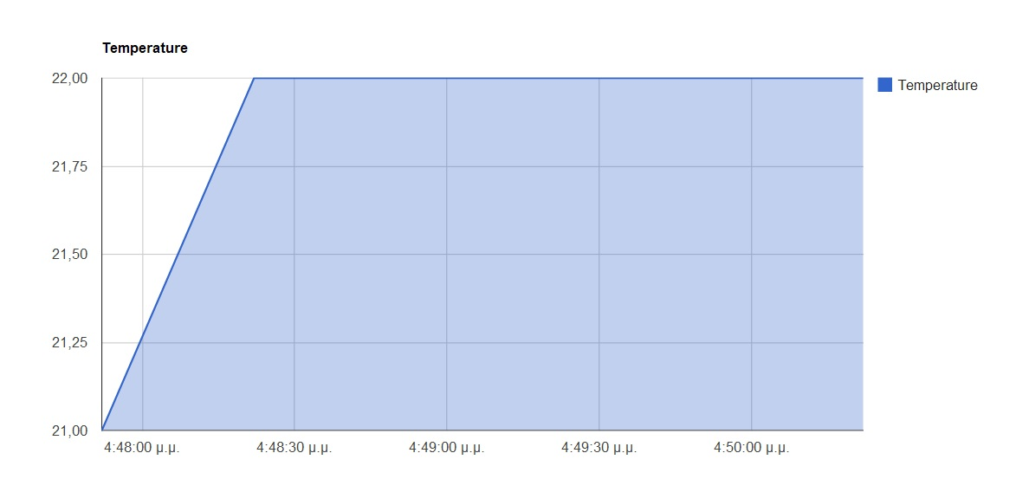
Trash/WS_2.jpg
