bharath4793/Sensebox/Trash/WS_3.jpg

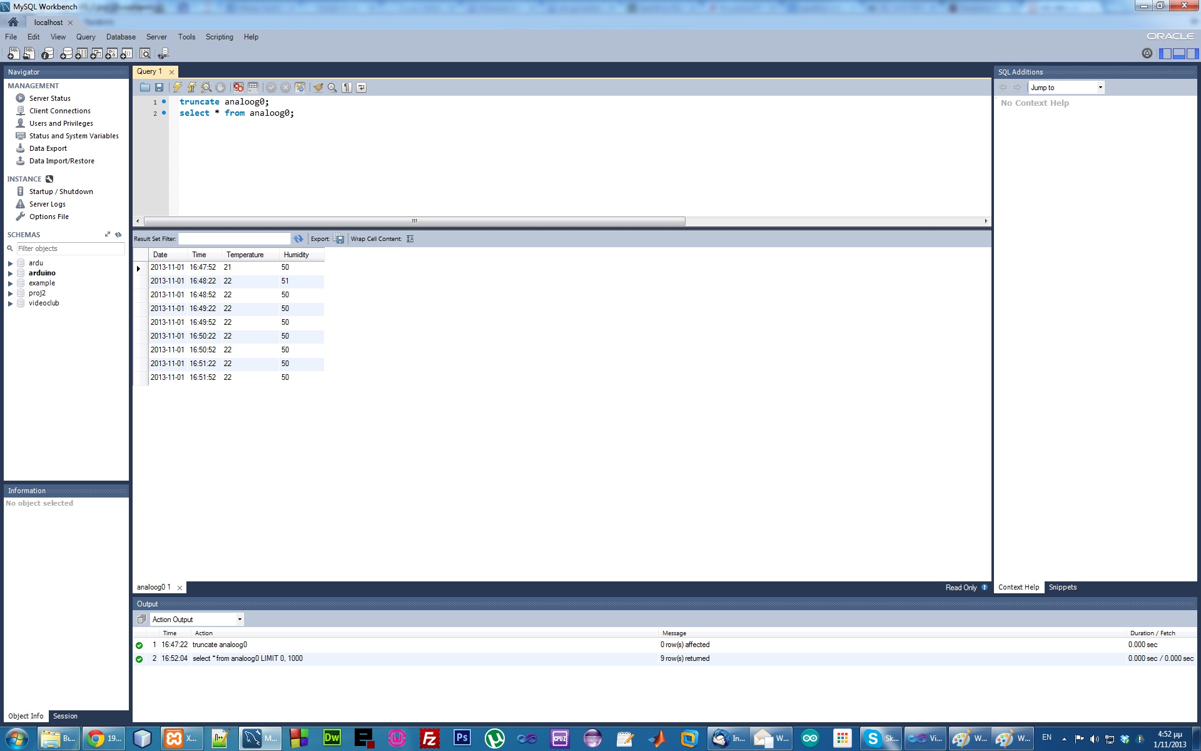
Trash/WS_3.jpg
