bharath4793/Sensebox/Trash/Χωρίς τίτλο.jpg

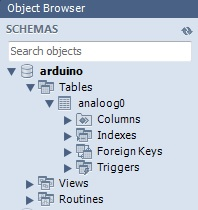
Trash/Χωρίς τίτλο.jpg
