bharath4793/Sensebox/Trash/Χωρίς τίτλο.png

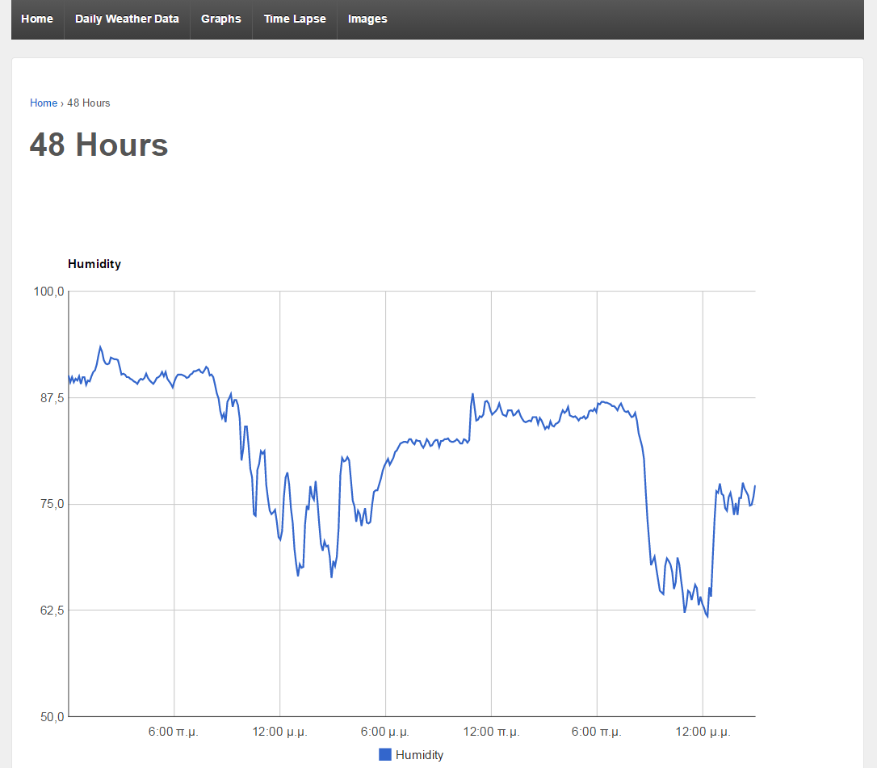
Trash/Χωρίς τίτλο.png
