bharath4793/Sensebox/Raw Data/Pics/draw_charts_code/makeURL_method.png

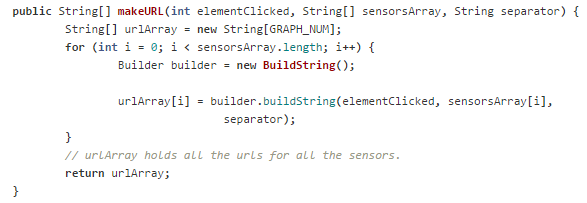
Raw Data/Pics/draw_charts_code/makeURL_method.png
