bharath4793/Sensebox/Raw Data/Pics/video_maker.png

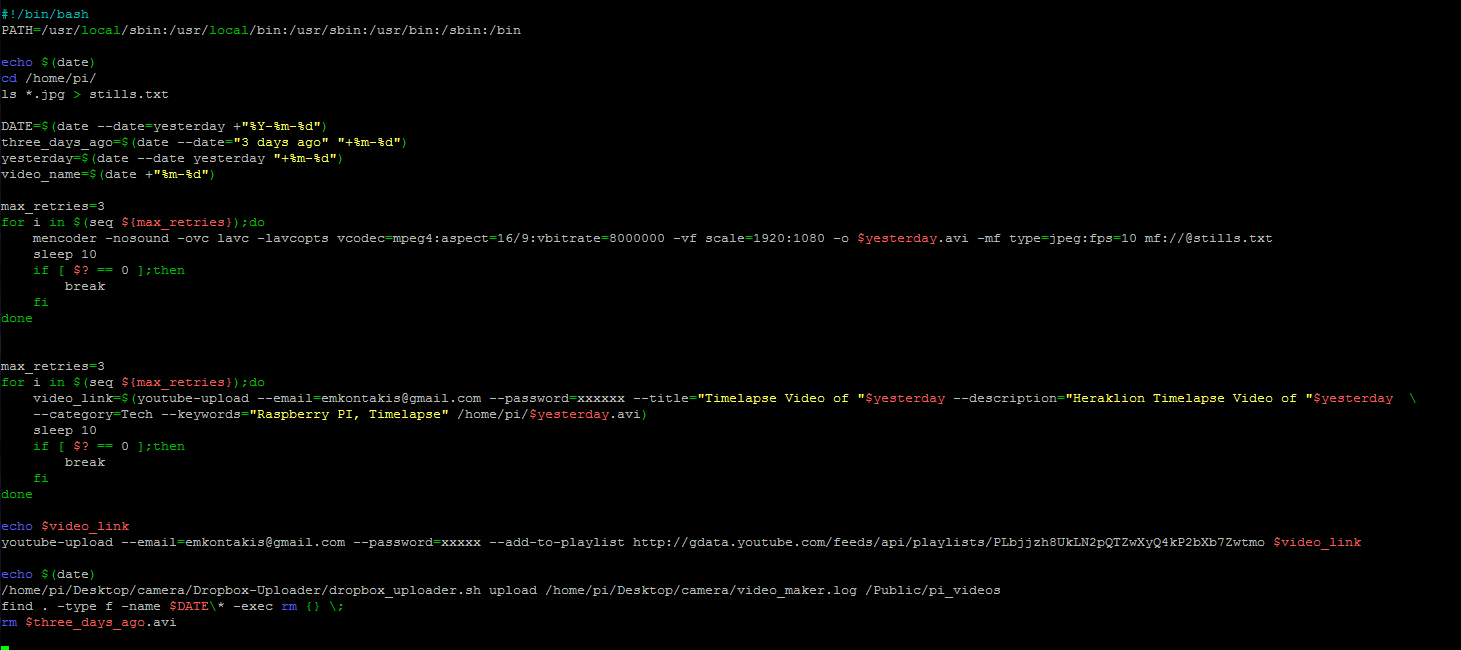
Raw Data/Pics/video_maker.png
