bharath4793/Sensebox/Raw Data/Pics/web_page/latest_results_script.png

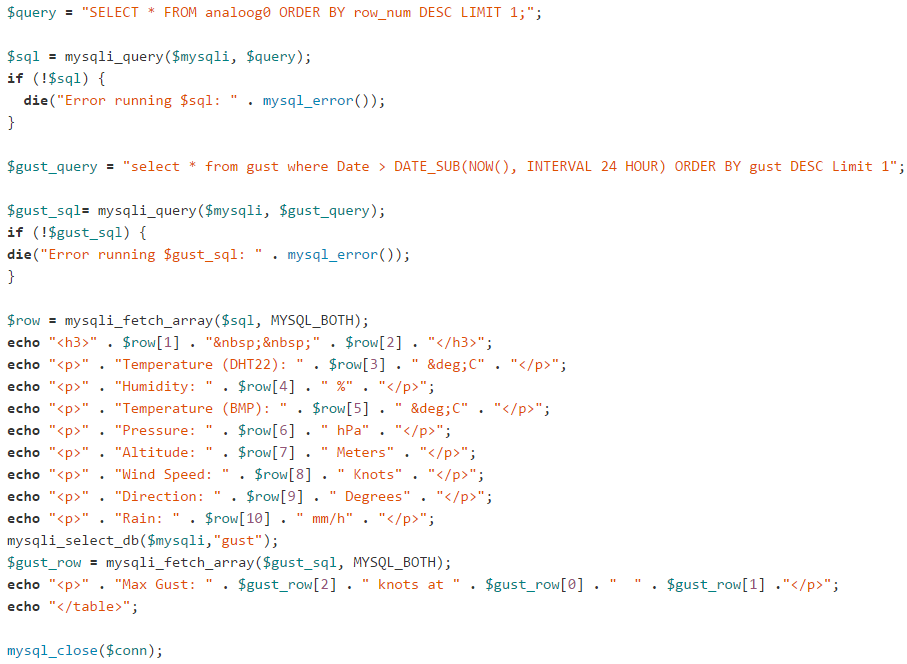
Raw Data/Pics/web_page/latest_results_script.png
