bharath4793/Sensebox/Raw Data/Pics/bouncing_problem.gif

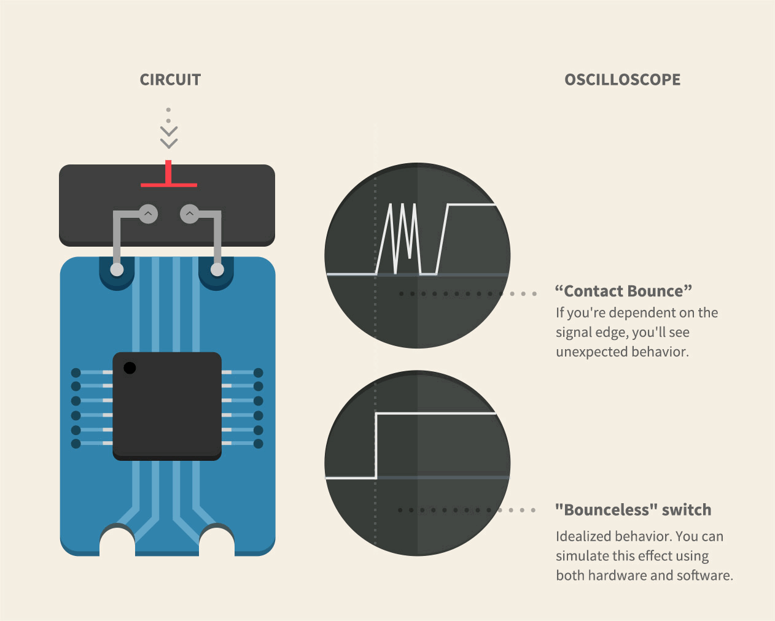
Raw Data/Pics/bouncing_problem.gif
