bharath4793/Sensebox/(list of files, drawings)

Other design files:
Raw Data/Schematic/schematic.fzz
Raw Data/Schematic/schematic_v2.fzz
