bharath4793/Sensebox/(commit log)

2014-07-10 Initial Project Version
    [ver1.sdf]
2014-07-15 Added Textual Report Activity (Current Conditions Only)
2014-07-28 Arduino Sketch Modifications, Android Performace Fixes
2014-08-22 Web Page Script Optimized
    [schematic.fzz]
2014-12-16 File Structure Fixed - Despaghetized
    [schematic.fzz, schematic_v2.fzz]
